redfescue/Giant-Heads/heads_title_1.jpg

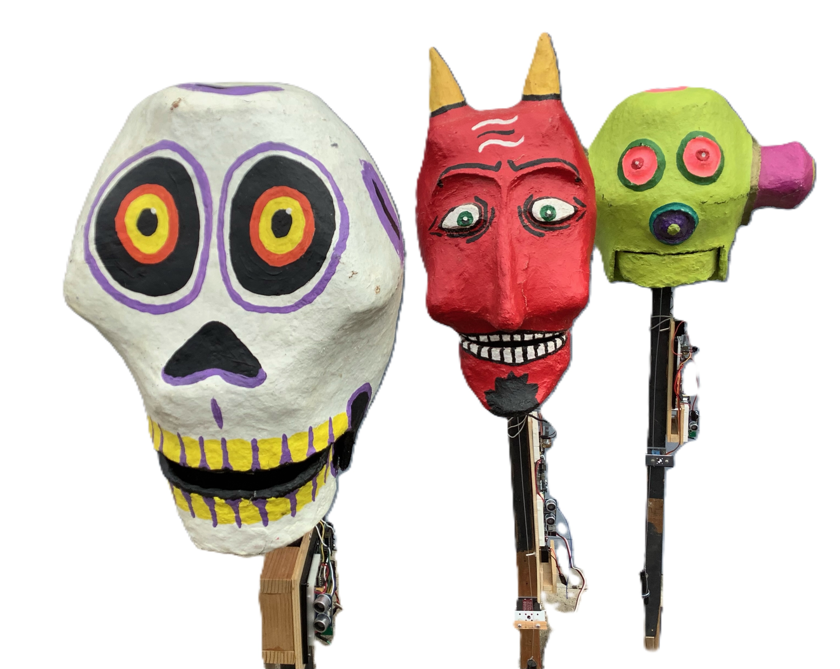
heads_title_1.jpg
