redfescue/Giant-Heads/README.md

# Giant-Heads
Arduino based interactive Giant Heads
These Giant Heads sense your presensce, play selected MP3 clips and send a readio signal to the next head. 
The next head responds and sends a radio signal to the next head, etc. 

The Giant Heads are in the Arduino Project Hub as "Installations" 
The document "Project Description Giant Heads" is the Arduino Project Hub Article text
